K-Eckert15/RockSAT/Main and SiPM BOM.csv

Index | Manufacturer Part Number | Manufacturer Name | Description | Lead Time | Availability | Stock Status | Datasheet | Original Part numbers | Image | Product Notes
1 | LT1807CS8#PBF | Analog Devices Inc. | IC OPAMP GP 2 CIRCUIT 8SO |  | 543 | In Stock | https://www.analog.com/media/en/technical-documentation/data-sheets/18067fc.pdf | LT1807CS8#PBF | https://mm.digikey.com/Volume0/opasdata/d220001/medias/images/4993/505%7E05-08-1610%7ES%2C-S8%7E8.jpg
2 | MC7805CTG | onsemi | IC REG LINEAR 5V 1A TO220 |  | 35,744 | In Stock | https://www.onsemi.com/pdf/datasheet/mc7800-d.pdf | MC7805CTG | https://mm.digikey.com/Volume0/opasdata/d220001/medias/images/6165/488%7E221AB-01%7ET%7E3.jpg
3 | 1N5818 | STMicroelectronics | DIODE SCHOTTKY 30V 1A DO41 |  | 150 | In Stock | https://www.st.com/content/ccc/resource/technical/document/datasheet/26/db/14/60/52/47/47/5b/CD00001625.pdf/files/CD00001625.pdf/jcr:content/translations/en.C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 | 497-4548-3-ND | https://mm.digikey.com/Volume0/opasdata/d220001/medias/images/4846/497_1N5819.JPG
4 | CBB0207001003GCT00 | Vishay Beyschlag/Draloric/BC Components | CBB 0207 2% CT 100K |  | 1,645 | In Stock | https://www.vishay.com/docs/28736/cbb0207.pdf | CBB0207001003GCT00 | https://mm.digikey.com/Volume0/opasdata/d220001/derivates/6/003/240/323/MFG_CBB020700xx0xGCT00_web%28640x640%29.jpg
5 | MBB0207VD2002BC100 | Vishay Beyschlag/Draloric/BC Components | RES 20K OHM 0.1% 0.4W AXIAL |  | 358 | In Stock | https://www.vishay.com/docs/28767/mbsmapre.pdf | MBB0207VD2002BC100 | https://mm.digikey.com/Volume0/opasdata/d220001/medias/images/2518/20k-Ohm-0%2C1%25.jpg
6 | MBB0207VD1002BCT00 | Vishay Beyschlag/Draloric/BC Components | MBB/SMA 0207-25 0.1% CECC 06 CT |  | 4,504 | In Stock | https://www.vishay.com/docs/28766/mbxsma.pdf | MBB0207VD1002BCT00 | https://mm.digikey.com/Volume0/opasdata/d220001/derivates/6/003/243/641/MFG_MBB0207_web%28640x640%29.jpg
7 | MBB0207VD1001BC100 | Vishay Beyschlag/Draloric/BC Components | RES 1K OHM 0.1% 0.4W AXIAL |  | 356 | In Stock | https://www.vishay.com/docs/28767/mbsmapre.pdf | MBB0207VD1001BC100 | https://mm.digikey.com/Volume0/opasdata/d220001/medias/images/2401/1k-Ohm-0%2C1%25.jpg
8 | MBB0207VD2500BC100 | Vishay Beyschlag/Draloric/BC Components | RES 250 OHM 0.1% 0.4W AXIAL |  | 715 | In Stock - Non-Stock | https://www.vishay.com/docs/28767/mbsmapre.pdf | MBB0207VD2500BC100 | https://mm.digikey.com/Volume0/opasdata/d220001/medias/images/2408/250-Ohm-0%2C1%25-Axial.jpg | Non Cancellable Non Returnable.
9 | RDEC71H106K3S1H03A | Murata Electronics | CAP CER 10UF 50V X7S RADIAL |  | 1,122 | In Stock | https://pim.murata.com/asset/pim4/ceramicCapacitorLead/RDE_X7R_X7S_25V-100V_E_PDF_CERAMICCAPACITORLEAD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 | RDEC71H106K3S1H03A | https://mm.digikey.com/Volume0/opasdata/d220001/medias/images/2583/RDE%20SERIES%205.5mm.jpg
10 | C320C104K5R5TA | KEMET | CAP CER 0.1UF 50V X7R RADIAL |  | 230,646 | In Stock | https://content.kemet.com/datasheets/KEM_C1050_GOLDMAX_X7R.pdf | C320C104K5R5TA | https://mm.digikey.com/Volume0/opasdata/d220001/medias/images/2079/Goldmax%2C-300.jpg
11 | C315C223K5R5TA7303 | KEMET | CAP CER 0.022UF 50V X7R RADIAL |  | 9,366 | In Stock | https://content.kemet.com/datasheets/KEM_C1050_GOLDMAX_X7R.pdf | C315C223K5R5TA7303 | https://mm.digikey.com/Volume0/opasdata/d220001/medias/images/631/GoldenMax32-SERIES.jpg
12 | C316C100K1G5TA | KEMET | CAP CER 10PF 100V C0G/NP0 RADIAL |  | 1,260 | In Stock | https://yageogroup.com/content/datasheet/asset/file/KEM_C1049_GOLDMAX_C0G | C316C100K1G5TA | https://mm.digikey.com/Volume0/opasdata/d220001/medias/images/2503/GOLDENMAX%20300%20C0G%2C%20NP0.jpg
13 | L77SDA15SVF | Amphenol ICC (Commercial Products) | CONN D-SUB RCPT 15POS SOLDER CUP |  | 257 | In Stock | https://cdn.amphenol-cs.com/media/wysiwyg/files/documentation/datasheet/inputoutput/io_d_sub_sd_hd_stamped_formed_solder_cup.pdf | L77SDA15SVF-ND | https://mm.digikey.com/Volume0/opasdata/d220001/medias/images/2143/L77SDA15SVF.jpg
14 | DA15P064TXLF | Amphenol ICC (FCI) | CONN D-SUB PLUG 15POS SOLDER CUP |  | 3,247 | In Stock | https://mm.digikey.com/Volume0/opasdata/d220001/medias/docus/6255/c-dsub-0064.pdf | 609-1512-ND | https://mm.digikey.com/Volume0/opasdata/d220001/medias/images/1086/DA15P064TXLF.jpg
