K-Eckert15/RockSAT/LMP_Circuit/LMP_Circuit/AQV101AZ/3D/AQV101AZ.stp

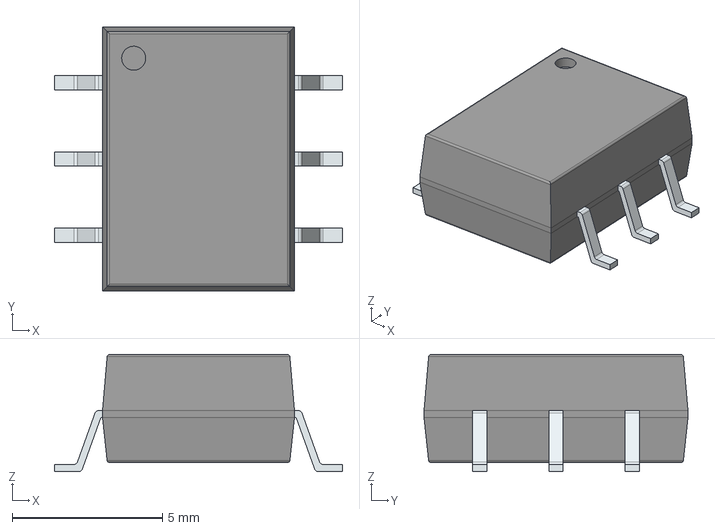
[picture p1: CAD file, 2026-03-13]
LMP_Circuit/LMP_Circuit/AQV101AZ/3D/AQV101AZ.stp
9.60 x 8.80 x 3.90 mm
PinsArrayLR
