K-Eckert15/RockSAT/(list of files, cad)

Other CAD files:
LMP_Circuit/LMP_Circuit/AQV101AZ/Allegro/sop254p960x390-6n.psm
LMP_Circuit/LMP_Circuit/AQV101AZ/DEHDL/aqv101az/chips/chips.prt
