K-Eckert15/RockSAT/(list of files, drawings)

Other design files:
LMP_Circuit/LMP_Circuit/AQV101AZ/Altium/AQV101AZ.SchLib
LMP_Circuit/LMP_Circuit/AQV101AZ/Altium/SOP254P960X390-6N.PcbLib
