K-Eckert15/RockSAT/LMP_Circuit/LMP_Circuit/LMP_Circuit.kicad_pcb

## KiCad design LMP_Circuit/LMP_Circuit/LMP_Circuit.kicad_pcb (2026-03-28)

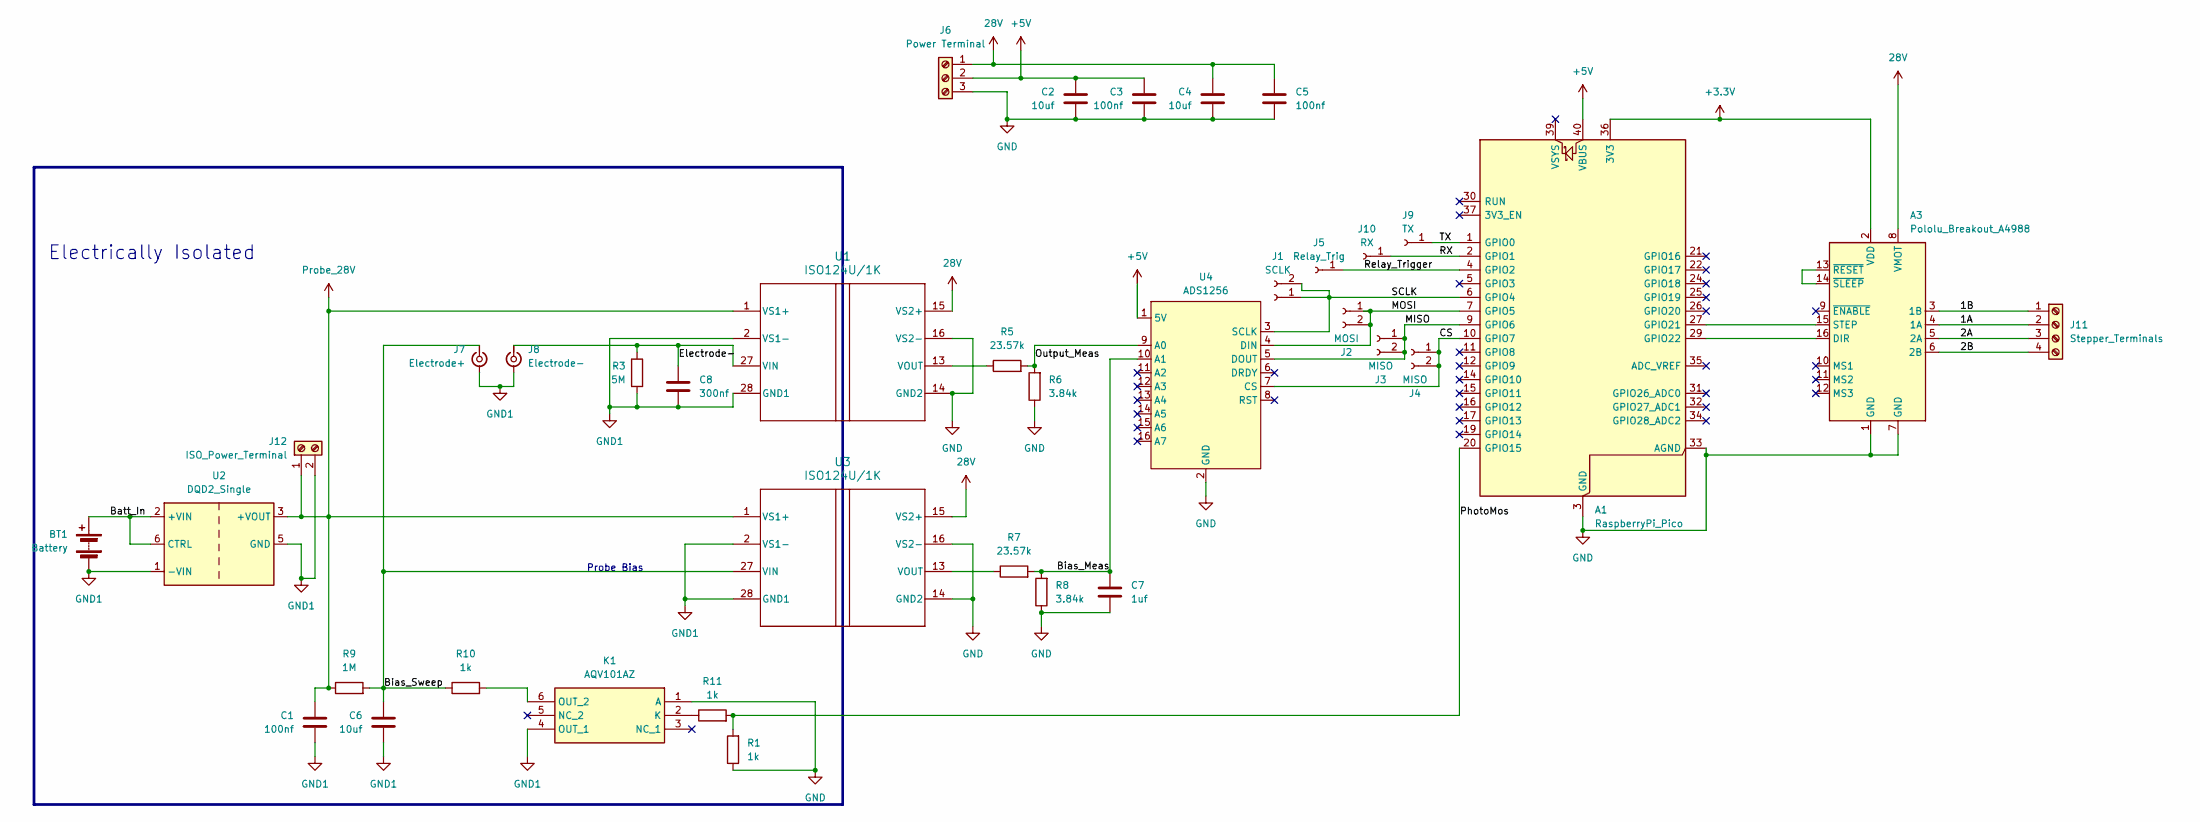
[picture p2: schematic LMP_Circuit.kicad_sch]

Parts:
A1: RaspberryPi_Pico; RaspberryPi_Pico_Common_Unspecified
A3: Pololu_Breakout_A4988; Pololu_Breakout-16_15.2x20.3mm
BT1: Battery; TerminalBlock_4Ucon_1x02_P3.50mm_Horizontal
C1, C3, C5: 100nf; C_0603_1608Metric; Manufacturer_Part_Number CC0603KRX7R9BB104
C2, C4, C6: 10uf; C_0603_1608Metric; Manufacturer_Part_Number GRM188R6YA106MA73D
C7: 1uf; C_0603_1608Metric; Manufacturer_Part_Number UMK107AB7105KA-T
C8: 300nf; C_0603_1608Metric; Manufacturer_Part_Number CGA3E3X7R1H334K080AB
J1: SCLK; PinHeader_1x02_P1.00mm_Vertical
J2: MOSI; PinHeader_1x02_P1.00mm_Vertical
J3, J4: MISO; PinHeader_1x02_P1.00mm_Vertical
J5: Relay_Trig; PinHeader_1x01_P1.00mm_Vertical
J6: Power Terminal; TerminalBlock_4Ucon_1x03_P3.50mm_Horizontal; Manufacturer_Part_Number 1984620
J7: Electrode+; SMA_Amphenol_901-143_Horizontal
J8: Electrode-; BNC_TEConnectivity_1478035_Horizontal
J9: TX; PinHeader_1x01_P1.00mm_Vertical
J10: RX; PinHeader_1x01_P1.00mm_Vertical
J11: Stepper_Terminals; TerminalBlock_4Ucon_1x04_P3.50mm_Horizontal; Manufacturer_Part_Number 1984633
J12: ISO_Power_Terminal; TerminalBlock_4Ucon_1x02_P3.50mm_Horizontal; Manufacturer_Part_Number ED555/2DS
K1: AQV101AZ; SOP254P960X390-6N; Mouser Part Number 769-AQV101AZ
R1, R10, R11: 1k; R_0603_1608Metric_Pad0.98x0.95mm_HandSolder; Manufacturer_Part_Number RMCF0603FT1K00
R3: 5M; R_0603_1608Metric_Pad0.98x0.95mm_HandSolder
R5, R7: 23.57k; R_0603_1608Metric_Pad0.98x0.95mm_HandSolder; Manufacturer_Part_Number RN73R1JTTD2342B25
R6, R8: 3.84k; R_0603_1608Metric_Pad0.98x0.95mm_HandSolder; Manufacturer_Part_Number ERA-3AEB3831V
R9: 1M; R_0603_1608Metric_Pad0.98x0.95mm_HandSolder; Manufacturer_Part_Number CRCW06031M00FKEA
U1, U3: ISO124U/1K; ISO124U
U2: DQD2_Single; DQD20
U4: ADS1256

Connections:
28V: A3.8 (VMOT), C4.1, C5.1, J6.1, U1.15 (VS2+), U3.15 (VS2+)
+3.3V: A1.36 (3V3), A3.2 (VDD)
+5V: A1.40 (VBUS), C2.1, C3.1, J6.2, U4.1 (5V)
/1A: A3.4 (1A), J11.2
/1B: A3.3 (1B), J11.1
/2A: A3.5 (2A), J11.3
/2B: A3.6 (2B), J11.4
/Bias_Meas: C7.2, R7.2, R8.2, U4.10 (A1)
/Bias_Sweep: C6.2, J7.1 (In), R9.2, R10.1, U3.27 (VIN)
/CS: A1.10 (GPIO7), J4.1, J4.2, U4.7 (CS)
/Electrode-: C8.2, J8.1 (In), R3.1, U1.27 (VIN)
/MISO: A1.9 (GPIO6), J3.1, J3.2, U4.5 (DOUT)
/MOSI: A1.7 (GPIO5), J2.1, J2.2, U4.4 (DIN)
/Output_Meas: R5.2, R6.2, U4.9 (A0)
/PhotoMos: A1.20 (GPIO15), R1.2, R11.2
/RX: A1.2 (GPIO1), J10.1
/Relay_Trigger: A1.4 (GPIO2), J5.1
/SCLK: A1.6 (GPIO4), J1.1, J1.2, U4.3 (SCLK)
/TX: A1.1 (GPIO0), J9.1
GND: A1.3 (GND), A1.8 (GND), A1.13 (GND), A1.18 (GND), A1.23 (GND), A1.28 (GND), A1.33 (AGND), A1.38 (GND), A3.1 (GND), A3.7 (GND), C2.2, C3.2, C4.2, C5.2, C7.1, J6.3, K1.1 (A), R1.1, R6.1, R8.1, U1.14 (GND2), U1.16 (VS2-), U3.14 (GND2), U3.16 (VS2-), U4.2 (GND)
GND1: BT1.2 (-), C1.2, C6.1, C8.1, J7.2 (Ext), J8.2 (Ext), J12.2, K1.4 (OUT_1), R3.2, U1.2 (VS1-), U1.28 (GND1), U2.1 (-VIN), U2.5 (GND), U3.2 (VS1-), U3.28 (GND1)
unnamed: A1.27 (GPIO21), A3.15 (STEP)
unnamed: A1.29 (GPIO22), A3.16 (DIR)
unnamed: A3.13 (~RESET), A3.14 (~SLEEP)
unnamed: BT1.1 (+), U2.2 (+VIN), U2.6 (CTRL)
unnamed: K1.2 (K), R11.1
unnamed: K1.6 (OUT_2), R10.2
unnamed: R5.1, U1.13 (VOUT)
unnamed: R7.1, U3.13 (VOUT)
Probe_28V: C1.1, J12.1, R9.1, U1.1 (VS1+), U2.3 (+VOUT), U3.1 (VS1+)

Notes on the sheet:
Probe Bias
Electrically Isolated

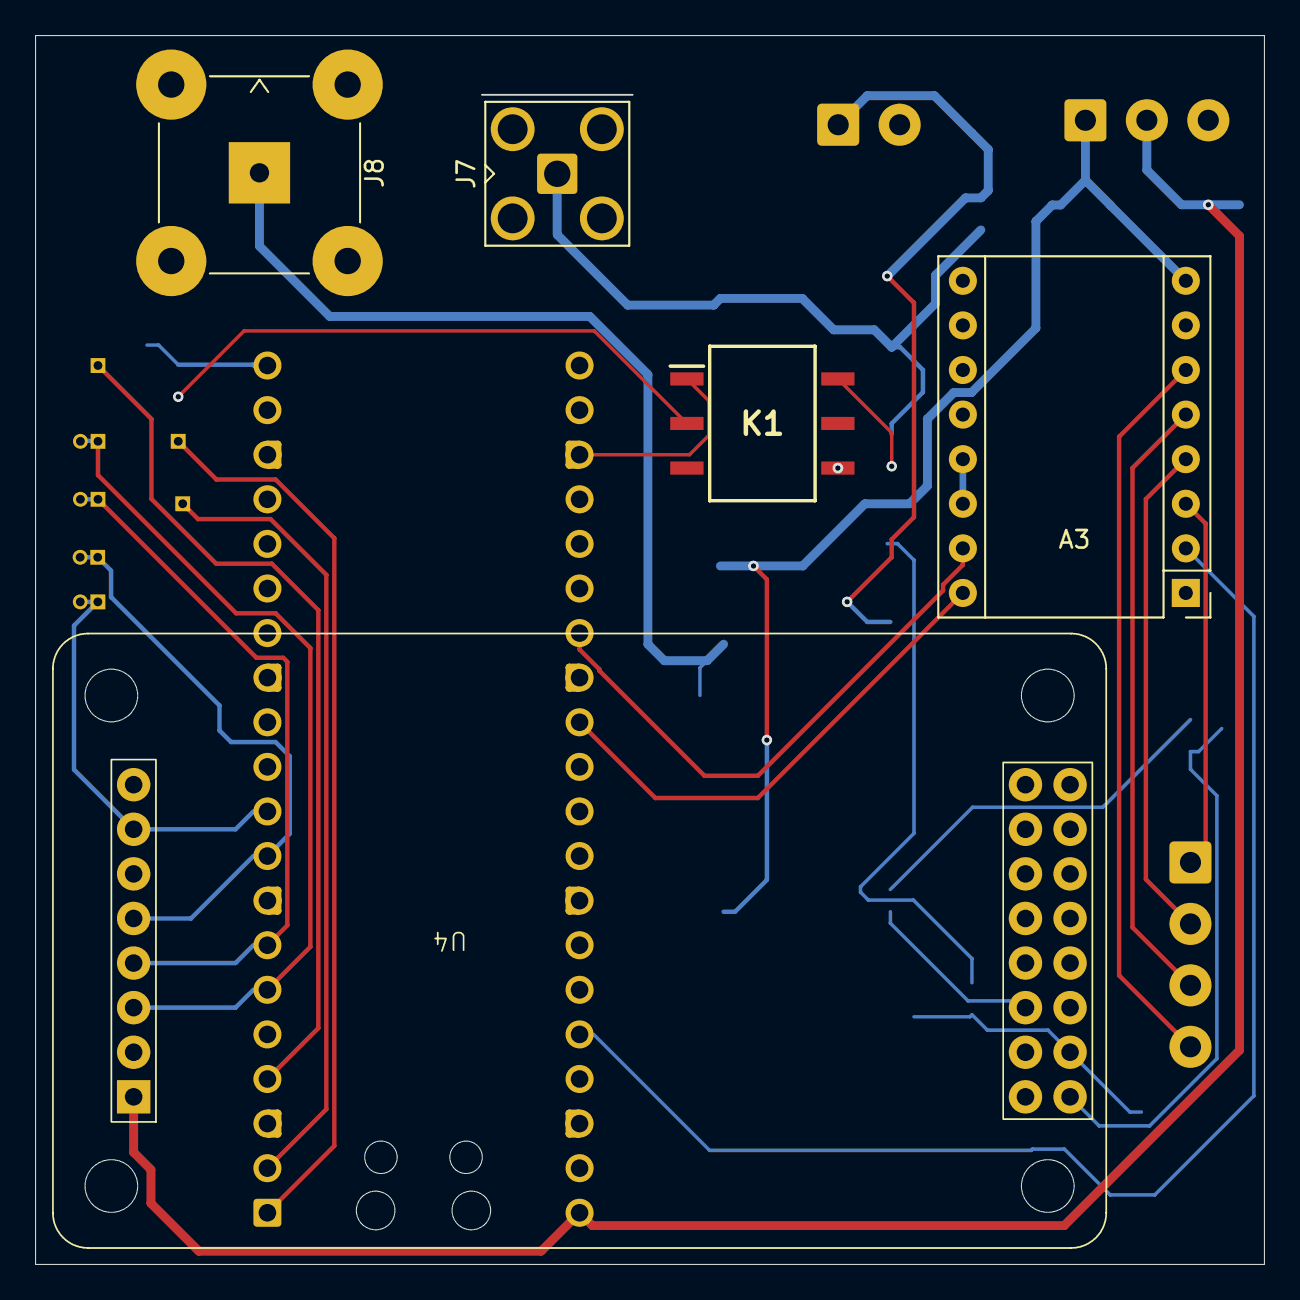
[picture p3: board LMP_Circuit.kicad_pcb from above]

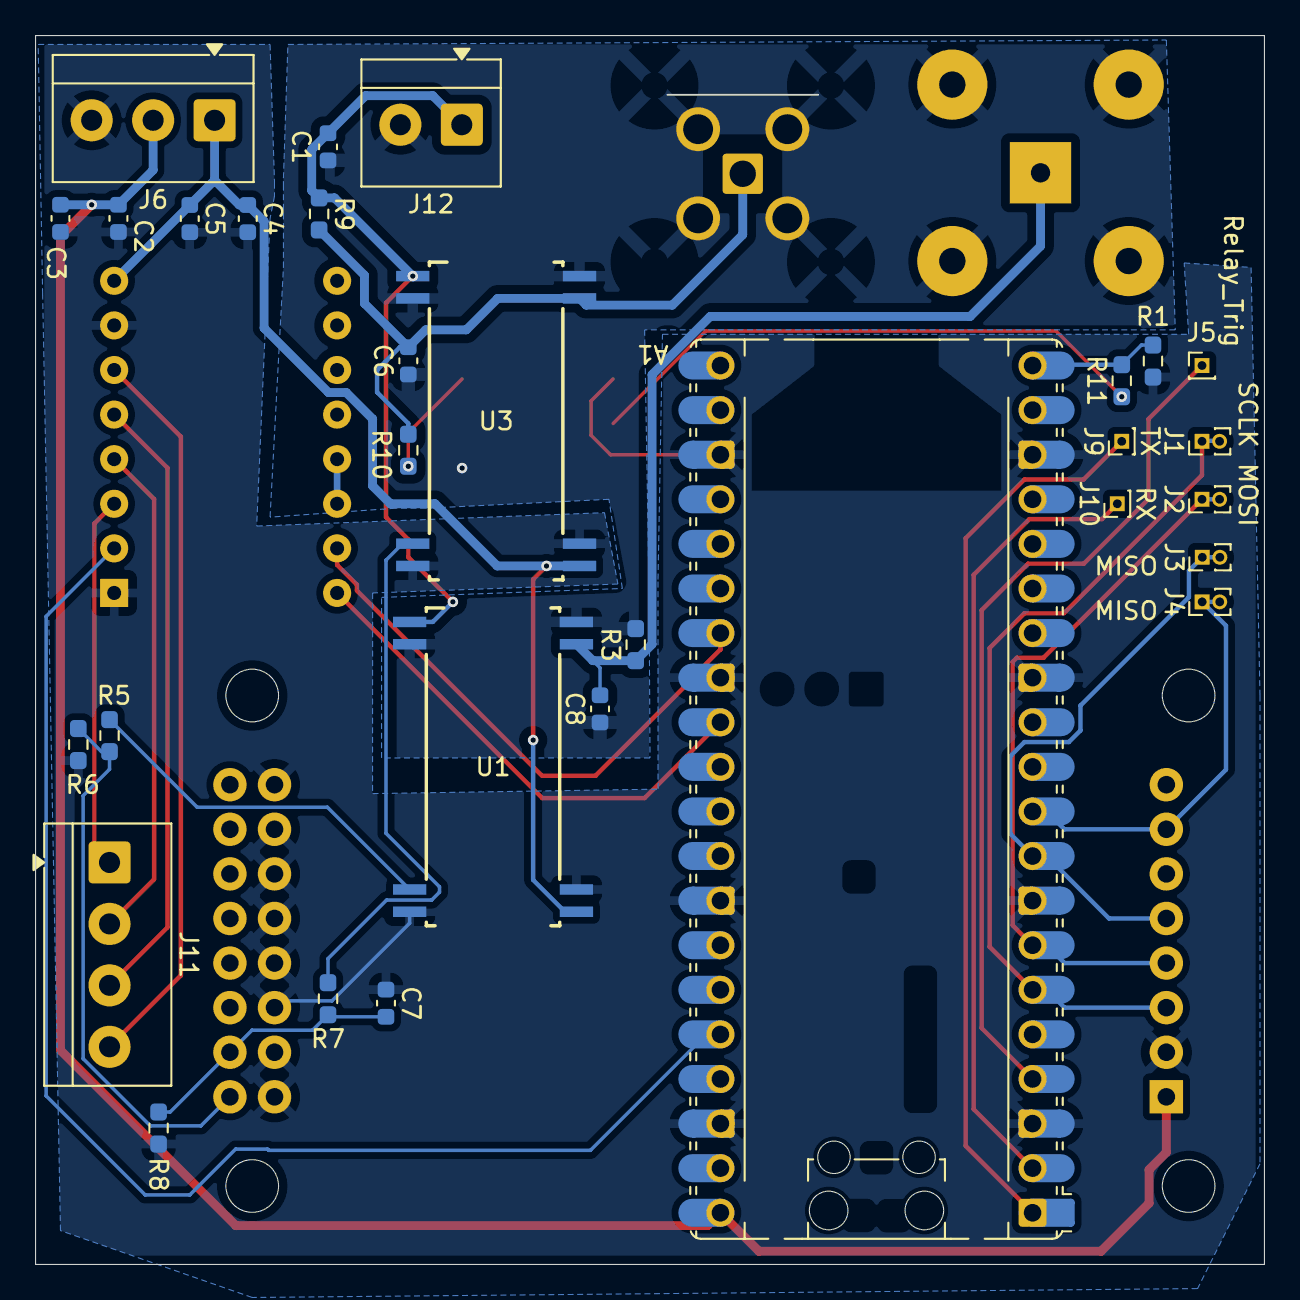
[picture p4: board LMP_Circuit.kicad_pcb from below]

Board: 2 copper layers, 70.0 x 70.0 mm, 35 parts (30 on the bottom side), 29 nets.
