K-Eckert15/RockSAT/Main Board_Muon/ROCKSAT_Modules_V1.kicad_pcb

## KiCad design Main Board_Muon/ROCKSAT_Modules_V1.kicad_pcb (2026-03-05)

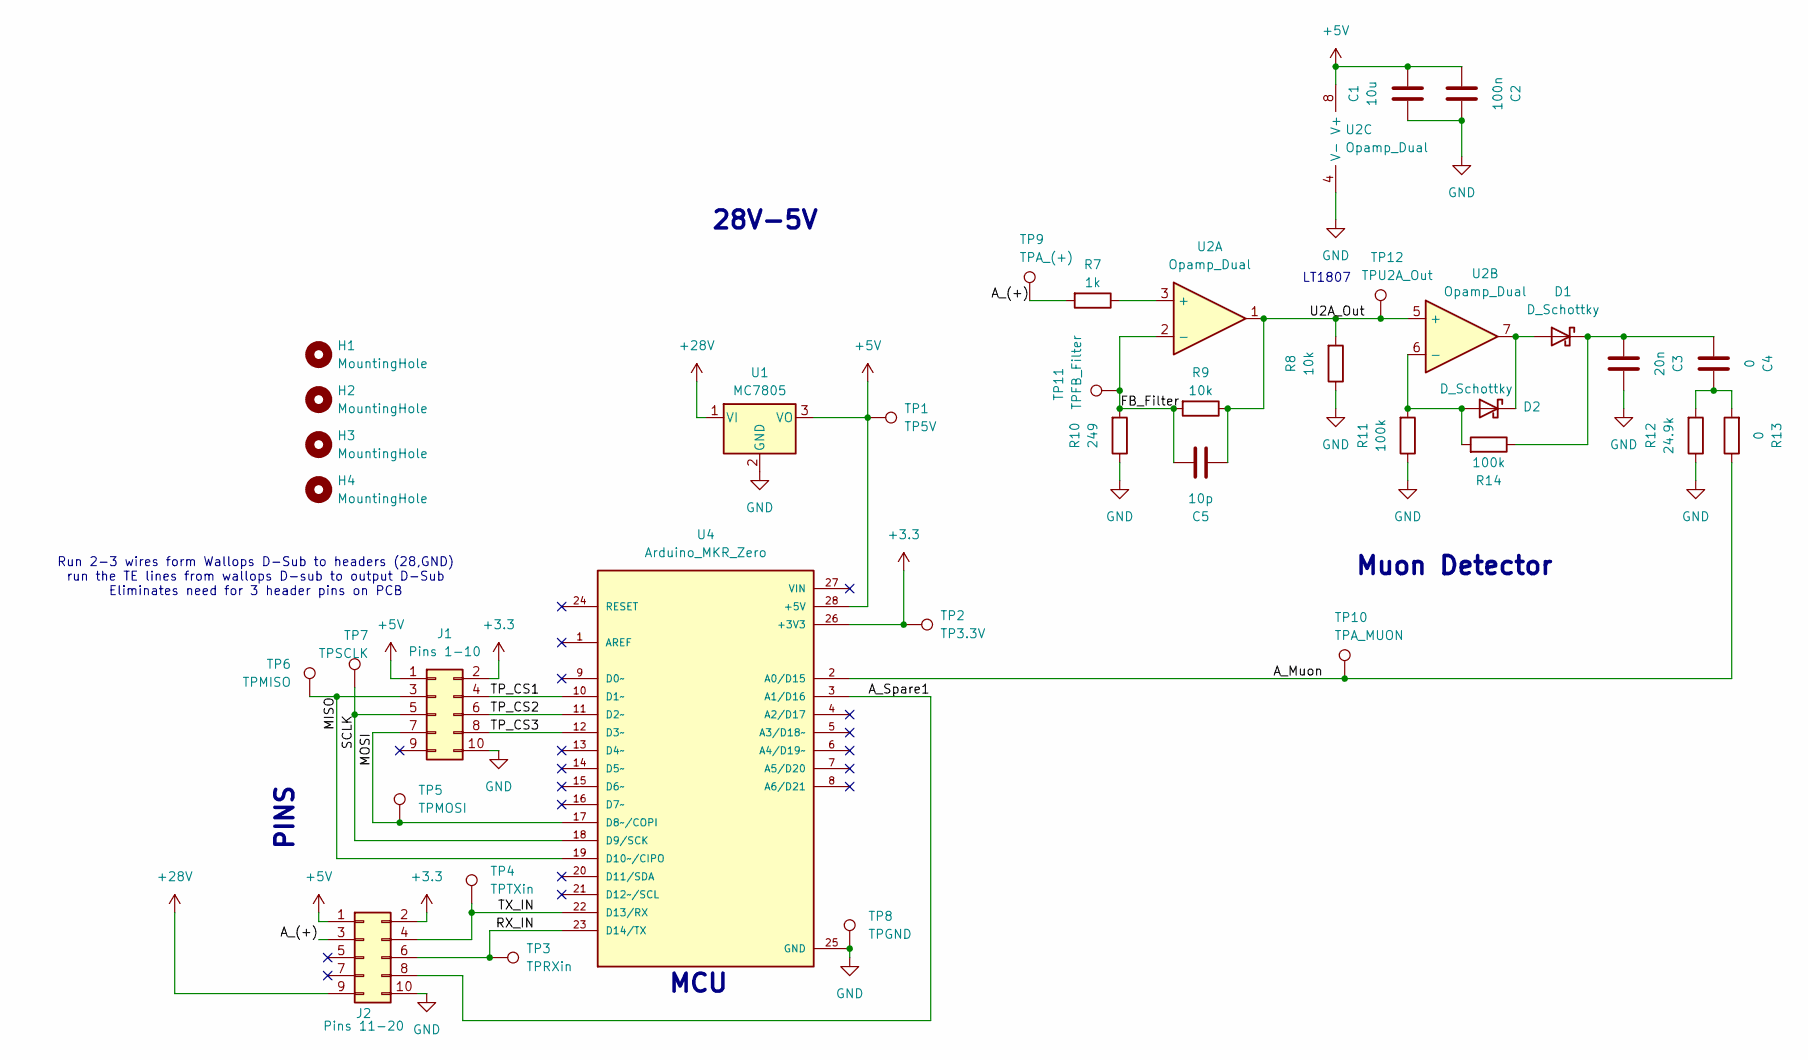
[picture p5: schematic ROCKSAT_Modules_V1.kicad_sch]

Parts:
C1: 10u; C_Disc_D3.8mm_W2.6mm_P2.50mm
C2: 100n; C_Disc_D3.8mm_W2.6mm_P2.50mm
C3: 20n; C_Disc_D3.8mm_W2.6mm_P2.50mm
C4: 0; C_Disc_D3.8mm_W2.6mm_P2.50mm
C5: 10p; C_Disc_D3.8mm_W2.6mm_P2.50mm
D1, D2: D_Schottky; D_A-405_P10.16mm_Horizontal
H1, H2, H3, H4: MountingHole; MountingHole_3.2mm_M3
J1: Pins 1-10; PinSocket_2x05_P2.54mm_Vertical
J2: Pins 11-20; PinSocket_2x05_P2.54mm_Vertical
R7: 1k; R_Axial_DIN0207_L6.3mm_D2.5mm_P7.62mm_Horizontal
R8, R9: 10k; R_Axial_DIN0207_L6.3mm_D2.5mm_P7.62mm_Horizontal
R10: 249; R_Axial_DIN0207_L6.3mm_D2.5mm_P7.62mm_Horizontal
R11, R14: 100k; R_Axial_DIN0207_L6.3mm_D2.5mm_P7.62mm_Horizontal
R12: 24.9k; R_Axial_DIN0207_L6.3mm_D2.5mm_P7.62mm_Horizontal
R13: 0; R_Axial_DIN0207_L6.3mm_D2.5mm_P7.62mm_Horizontal
TP1: TP5V; TestPoint_THTPad_D1.5mm_Drill0.7mm
TP2: TP3.3V; TestPoint_THTPad_D1.5mm_Drill0.7mm
TP3: TPRXin; TestPoint_THTPad_D1.5mm_Drill0.7mm
TP4: TPTXin; TestPoint_THTPad_D1.5mm_Drill0.7mm
TP5: TPMOSI; TestPoint_THTPad_D1.5mm_Drill0.7mm
TP6: TPMISO; TestPoint_THTPad_D1.5mm_Drill0.7mm
TP7: TPSCLK; TestPoint_THTPad_D1.5mm_Drill0.7mm
TP8: TPGND; TestPoint_THTPad_D1.5mm_Drill0.7mm
TP9: TPA_(+); TestPoint_THTPad_D1.5mm_Drill0.7mm
TP10: TPA_MUON; TestPoint_THTPad_D1.5mm_Drill0.7mm
TP11: TPFB_Filter; TestPoint_THTPad_D1.5mm_Drill0.7mm
TP12: TPU2A_Out; TestPoint_THTPad_D1.5mm_Drill0.7mm
U1: MC7805; TO-220-3_Horizontal_TabDown
U2: Opamp_Dual; SOIC-8_3.9x4.9mm_P1.27mm
U4: Arduino_MKR_Zero; MODULE_ABX00011; PARTREV 02/04/2020

Connections:
+3.3: J1.2, J2.2, TP2.1, U4.26 (+3V3)
+5V: C1.2, C2.2, J1.1, J2.1, TP1.1, U1.3 (VO), U2.8 (V+), U4.28 (+5V)
+28V: J2.9, U1.1 (VI)
/A_(+): J2.3, R7.2, TP9.1
/A_Muon: R13.1, TP10.1, U4.2 (A0/D15)
/A_Spare1: J2.8, U4.3 (A1/D16)
/FB_Filter: C5.1, R9.2, R10.2, TP11.1, U2.2 (-)
/MISO: J1.3, TP6.1, U4.19 (D10~/CIPO)
/MOSI: J1.7, TP5.1, U4.17 (D8~/COPI)
/RX_IN: J2.6, TP3.1, U4.23 (D14/TX)
/SCLK: J1.5, TP7.1, U4.18 (D9/SCK)
/TP_CS1: J1.4, U4.10 (D1~)
/TP_CS2: J1.6, U4.11 (D2~)
/TP_CS3: J1.8, U4.12 (D3~)
/TX_IN: J2.4, TP4.1, U4.22 (D13/RX)
/U2A_Out: C5.2, R8.2, R9.1, TP12.1, U2.1, U2.5 (+)
GND: C1.1, C2.1, C3.1, J1.10, J2.10, R8.1, R10.1, R11.1, R12.1, TP8.1, U1.2 (GND), U2.4 (V-), U4.25 (GND)
unnamed: C4.1, R12.2, R13.2
unnamed: D1.2 (A), D2.1 (K), U2.7
unnamed: C3.2, C4.2, D1.1 (K), R14.1
unnamed: D2.2 (A), R11.2, R14.2, U2.6 (-)
unnamed: R7.1, U2.3 (+)

Notes on the sheet:
Run 2-3 wires form Wallops D-Sub to headers (28,GND) run the TE lines from wallops D-sub to output D-Sub Eliminates need for 3 header pins on PCB
LT1807
MCU
28V-5V
Muon Detector
PINS

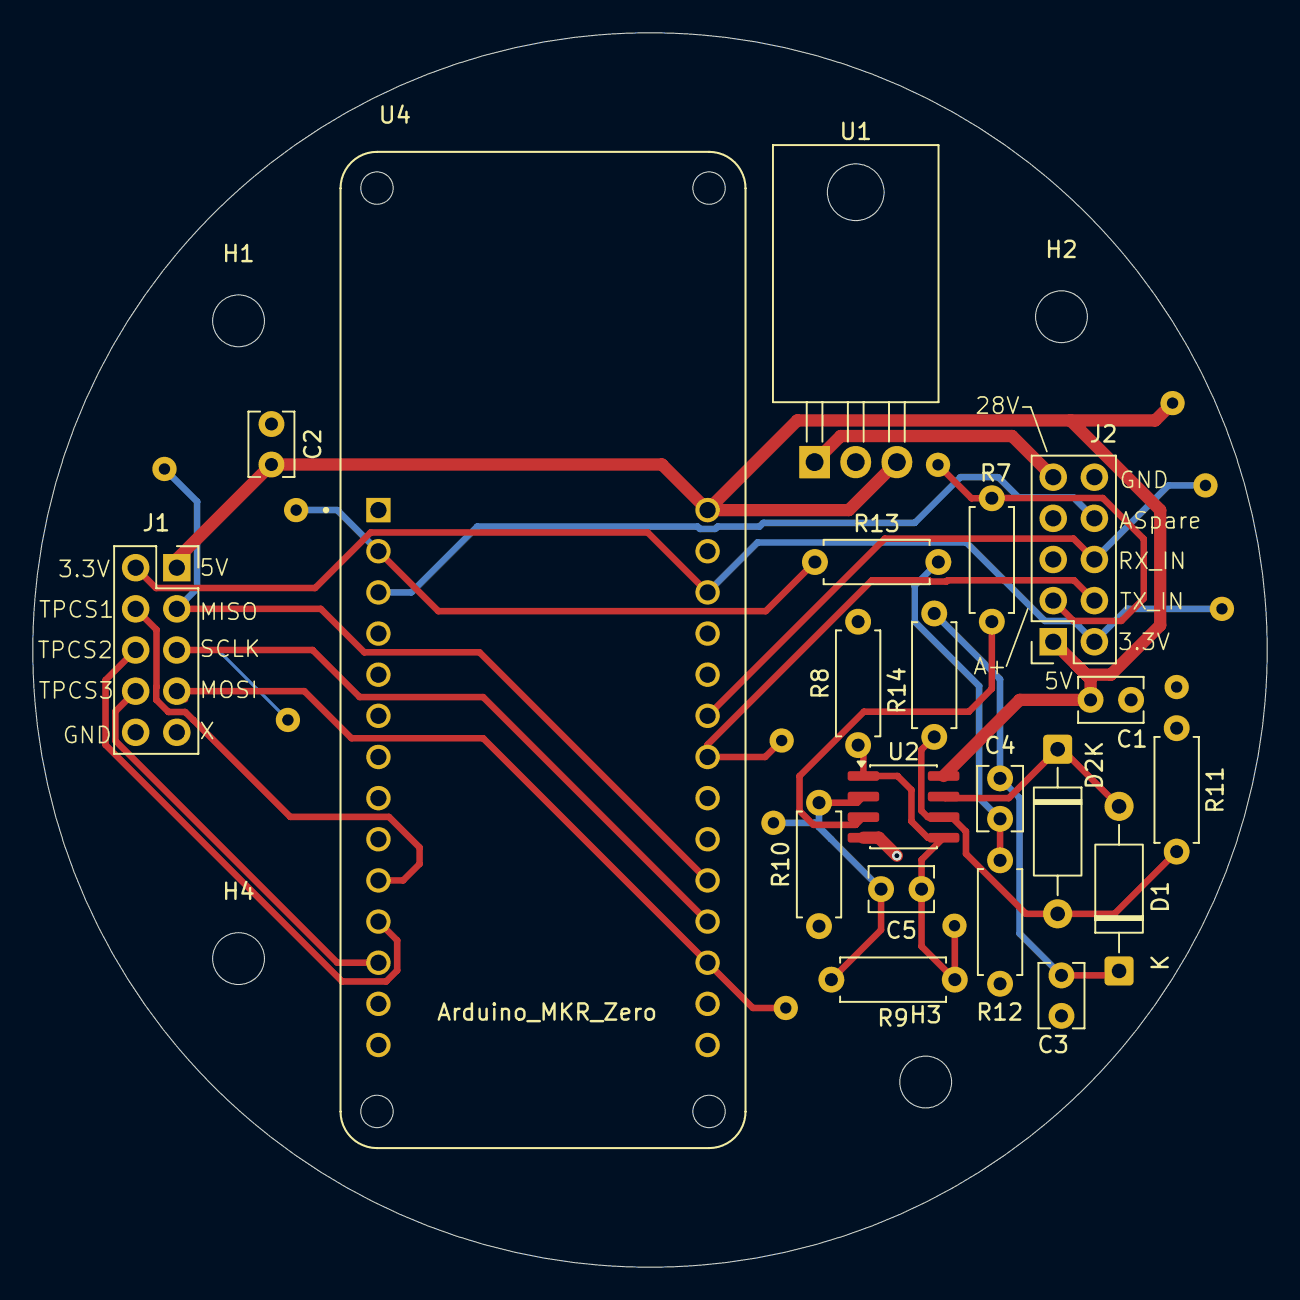
[picture p6: board ROCKSAT_Modules_V1.kicad_pcb from above]

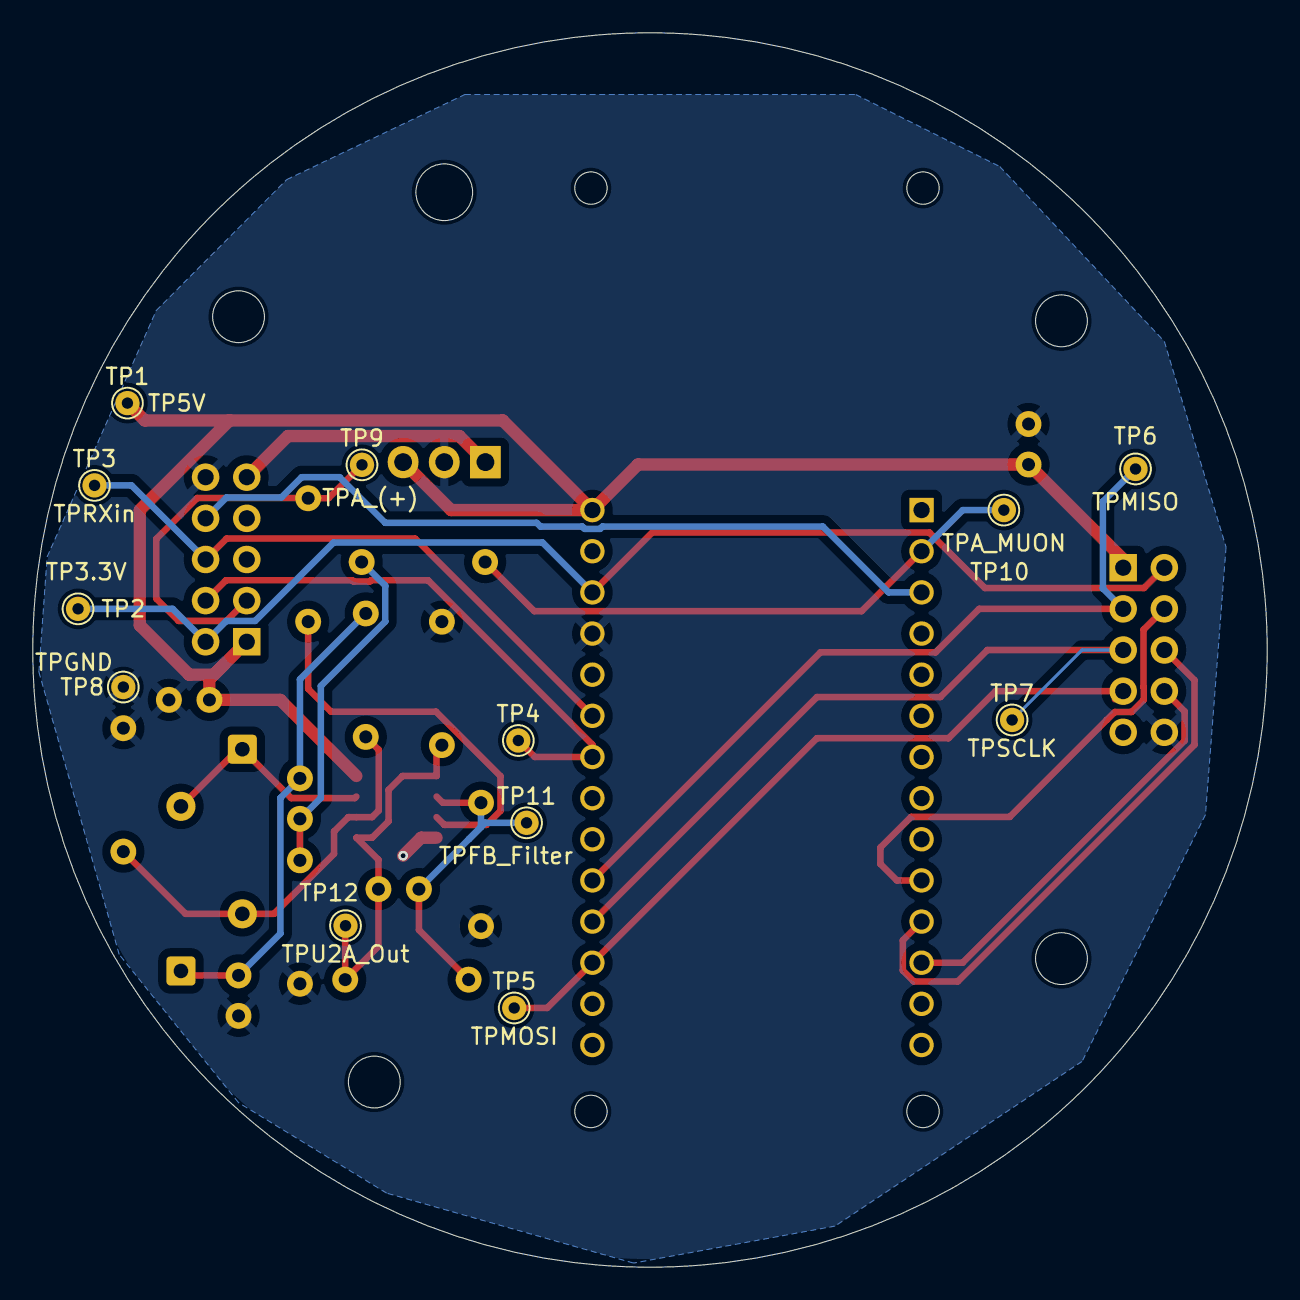
[picture p7: board ROCKSAT_Modules_V1.kicad_pcb from below]

Board: 2 copper layers, 76.2 x 76.2 mm, 36 parts (12 on the bottom side), 22 nets.
