K-Eckert15/RockSAT/(commit log)

2026-02-25 Initializing Files
    Added Main Board
    [ROCKSAT_Modules_Original.kicad_sch, ROCKSAT_Modules_V1.kicad_pcb, ROCKSAT_Modules_V1.kicad_sch, SiPM_Board.kicad_pcb]
2026-02-25 Created Files
    [LMP_Circuit.kicad_pcb, LMP_Circuit.kicad_sch]
2026-02-26 mounting holes fixed. Mosfet Tab Down. Module Ready.
    [ROCKSAT_Modules_V1.kicad_pcb, ROCKSAT_Modules_V1.kicad_sch]
2026-02-26 ADC, MCU, and Driver Added
    [LMP_Circuit.kicad_pcb, LMP_Circuit.kicad_sch]
2026-03-05 Test Points Added
    [ROCKSAT_Modules_V1.kicad_pcb, ROCKSAT_Modules_V1.kicad_sch]
2026-03-05 gerber files generated
    [ROCKSAT_Modules_V1-B_Cu.gbr, ROCKSAT_Modules_V1-B_Mask.gbr, ROCKSAT_Modules_V1-B_Paste.gbr, ROCKSAT_Modules_V1-B_Silkscreen.gbr, ROCKSAT_Modules_V1-Edge_Cuts.gbr, ROCKSAT_Modules_V1-F_Cu.gbr, ROCKSAT_Modules_V1-F_Mask.gbr, ROCKSAT_Modules_V1-F_Paste.gbr]
2026-03-08 added power converter diagram and relay.
    [LMP_Circuit.kicad_pcb, LMP_Circuit.kicad_sch]
2026-03-12 schematic near completion. Most likely functional.
    [LMP_Circuit.kicad_sch]
2026-03-12 initial layout created.
    [LMP_Circuit.kicad_pcb, LMP_Circuit.kicad_sch]
2026-03-12 Fully routed, lacks photomosfet
    [LMP_Circuit.kicad_pcb]
2026-03-13 Added Photomos. finished layout
    [AQV101AZ.SchLib, AQV101AZ.stp, EDI2CAP.CFG, LMP_Circuit.kicad_pcb, LMP_Circuit.kicad_sch, SOP254P960X390-6N.PcbLib, chips.prt, sop254p960x390-6n.psm]
2026-03-13 Gerber Files created
    [LMP_Circuit-B_Cu.gbr, LMP_Circuit-B_Mask.gbr, LMP_Circuit-B_Paste.gbr, LMP_Circuit-B_Silkscreen.gbr, LMP_Circuit-Edge_Cuts.gbr, LMP_Circuit-F_Cu.gbr, LMP_Circuit-F_Mask.gbr, LMP_Circuit-F_Paste.gbr]
2026-03-13 finished PCB layout with Photomos
    [LMP_Circuit.kicad_pcb, LMP_Circuit.kicad_sch]
2026-03-13 Electrode Added and Gerber files produced.
    [Electrode-B_Cu.gbr, Electrode-B_Mask.gbr, Electrode-B_Paste.gbr, Electrode-B_Silkscreen.gbr, Electrode-Edge_Cuts.gbr, Electrode-F_Cu.gbr, Electrode-F_Mask.gbr, Electrode-F_Paste.gbr]
2026-03-18 SiPM Gerber Files
    [SiPM_Board-B_Cu.gbr, SiPM_Board-B_Mask.gbr, SiPM_Board-B_Paste.gbr, SiPM_Board-B_Silkscreen.gbr, SiPM_Board-Edge_Cuts.gbr, SiPM_Board-F_Cu.gbr, SiPM_Board-F_Mask.gbr, SiPM_Board-F_Paste.gbr]
2026-03-22 BOM Updates
    [ROCKSAT_Modules_V1.kicad_sch]
2026-03-22 BOM Completed 3-22-26
    [ROCKSAT_Modules_V1.kicad_sch]
2026-03-22 BOM Exported
    [ROCKSAT_Modules_V1_BOM.csv]
2026-03-23 LMP BOM updates
    [LMP_Circuit.kicad_sch]
2026-03-23 LMP BOM started
    [LMP_Circuit_BOM.csv]
2026-03-28 sipm BOM added, files organized a bit more
    [LMP_Circuit.kicad_pcb, LMP_Circuit.kicad_sch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]
2026-03-28 BOM Addeed
    [SIPM board BOM.csv]
2026-04-01 Main Board and SiPM board Parts List
    [2026-04-01T121725.csv]
2026-04-01 Rename 2026-04-01T121725.csv to Main and SiPM BOM.csv
    [Main and SiPM BOM.csv]
2026-04-03 Update Main and SiPM BOM.csv
    [Main and SiPM BOM.csv]
2026-04-03 D-Sub added
    [Main and SiPM BOM.csv]
2026-04-03 Male D-sub added
    [Main and SiPM BOM.csv]
2026-04-10 Updated BOM
    [SIPM board BOM.csv]
2026-04-10 added qtys
    [Rocksat_Main+SIPM.csv]
